kris2475/Integrated-Spectral-Photovoltaic-System/Integrated_Spectral_PV5/sensor_log_20261022_085958.csv

RecordType | Timestamp | Voltage_V | Current_A | Power_W | DutyCycle | Temp_C | Pressure_hPa | Humidity_perc | Gas_Ohm | Lux | IntegrationTime_us | Max_ADC | Saturation_Status | 302.54nm | 305.24nm | 307.94nm | 310.64nm | 313.34nm | 316.03nm | 318.73nm | 321.42nm | 324.10nm | 326.79nm | 329.47nm | 332.15nm | 334.82nm | 337.50nm | 340.17nm | 342.83nm | 345.50nm | 348.16nm | 350.82nm | 353.47nm | 356.12nm | 358.77nm | 361.42nm | 364.06nm | 366.70nm | 369.34nm | 371.97nm | 374.60nm | 377.22nm | 379.84nm | 382.46nm | 385.08nm | 387.69nm | 390.30nm | 392.90nm | 395.50nm | 398.10nm | 400.69nm | 403.28nm | 405.86nm | 408.44nm | 411.02nm | 413.59nm | 416.16nm | 418.72nm | 421.28nm
LIVE | "2026-10-22 09:00:09.840" | 1.5328 | 0.000197 | 0.000302 | 120 | 25.0 | 1009.2 | 44.8 | 323283 | 535.0 | 682776 | 2099 | UNSATURATED | 272 | 341 | 323 | 307 | 318 | 320 | 322 | 308 | 305 | 327 | 336 | 314 | 304 | 311 | 331 | 309 | 303 | 304 | 306 | 316 | 302 | 317 | 307 | 318 | 310 | 313 | 311 | 322 | 317 | 317 | 314 | 309 | 311 | 315 | 320 | 310 | 316 | 335 | 314 | 331 | 336 | 331 | 341 | 363 | 372 | 399
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
