kris2475/Integrated-Spectral-Photovoltaic-System/Integrated_Spectral_PV5/Screenshot_2026.png

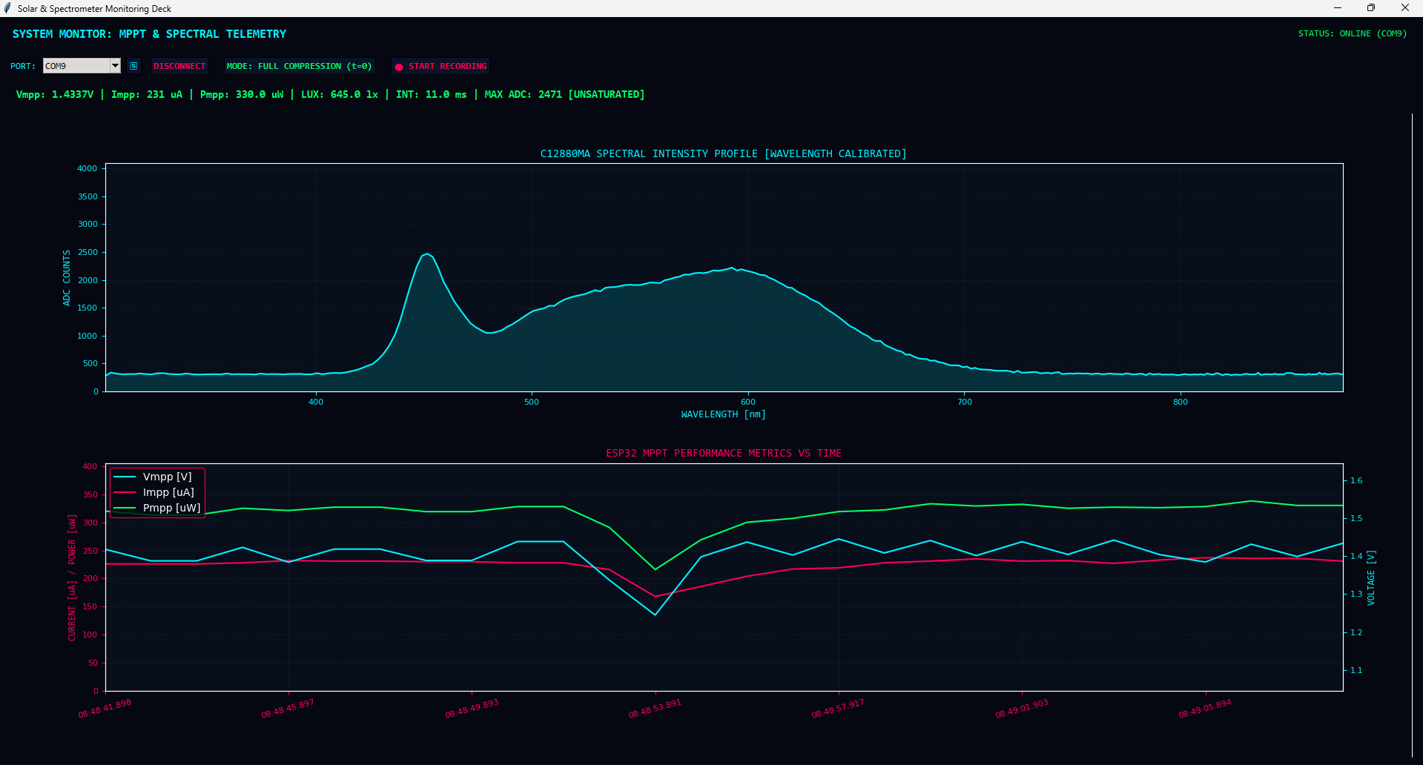
Integrated_Spectral_PV5/Screenshot_2026.png
