kris2475/Integrated-Spectral-Photovoltaic-System/(commit log)

2026-10-22 Create README for ISPV-5 project
    Added README.md for Integrated Spectral Photovoltaic System (ISPV-5) detailing system overview, hardware connections, optical calibration, firmware highlights, and telemetry dashboard.
2026-10-22 Remove duplicate smoothing explanation in documentation
    Removed duplicate explanation of exponential moving average smoothing for voltage, current, and power measurements.
