kris2475/Integrated-Spectral-Photovoltaic-System/(notices)

Notices in the files:
README.md:
License: MIT
